OlegMishin/A1200_8MB_FASTRAM/Doc/IMG_5395.JPG

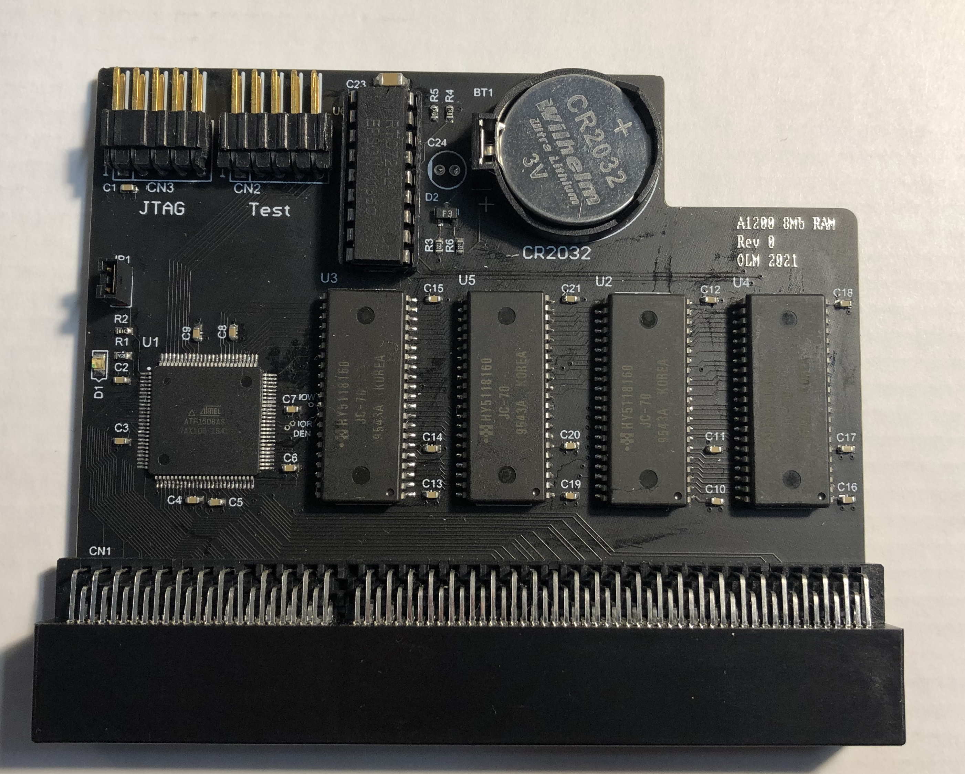
Doc/IMG_5395.JPG
