OlegMishin/A1200_8MB_FASTRAM/pcb/A1200_8MB_OLM-V2_BOM.pdf

No. | Quantity Designator | | Value | Part | Description
1 | 1 | BT1 | CR2032 holder | CR2032 holder | Battery holder
2 | 22 | C1, C2, C3, C4, C5, C6, C7, C8, C9, C10, C11, C12, C13, C14, C15, C16, C17, C18, C19, C20, C21, C22 | 100nF | 100nF 50V 0603 | Capacitor
3 | 1 | C23 | 10uF | 10uF 16V 1206 | Capacitor
4 | 1 | C24 | 100uF | 100uF 16V D5 | Polarized Capacitor
5 | 2 | C25, C26 | 22pF | 22pF 50V 0603 | Ceramic capacitor SMD
6 | 1 | CN1 | A1200_EXP_CONN | A1200_EXP_CONN | A1200_150pin_expansion_connector
7 | 1 | CN3 | PLD-10R | PLD-10R | Header, 5-Pin, Dual row, Right Angle
8 | 1 | D1 | APTD3216MGC | APTD3216MGC | LED SMD 1206
9 | 1 | D2 | BAT54C | BAT54C | Schottky Barrier Double Diode
10 | 1 | JP1 | PLS-2 | PLS-2 | Header, 2-Pin
11 | 3 | R1, R3, R6 | 470 | 470 5% 0603 | Resistor
12 | 3 | R2, R4, R5 | 10K | 10K 5% 0603 | Resistor
13 | 1 | U1 | ATF1508AS-7AX100 | ATF1508AS-7AX100 | MAX 7000S 5V CPLD
14 | 4 | U2, U3, U4, U5 | MSM5118160 | MSM5118160 | 1Mx16 DRAM
15 | 1 | U6 | RTC72421 | RTC72421 | RTC IC
16 | 1 | ZQ1 | 32.768kHz | 830002996B Wurth Elektronik | Quarze WE-XTAL 32.7680kHz 20ppm WATCH 3X8

Страница 1 из 1
