OlegMishin/A1200_8MB_FASTRAM/pcb/A1200_8MB_OLM-V2_Schematics.PDF

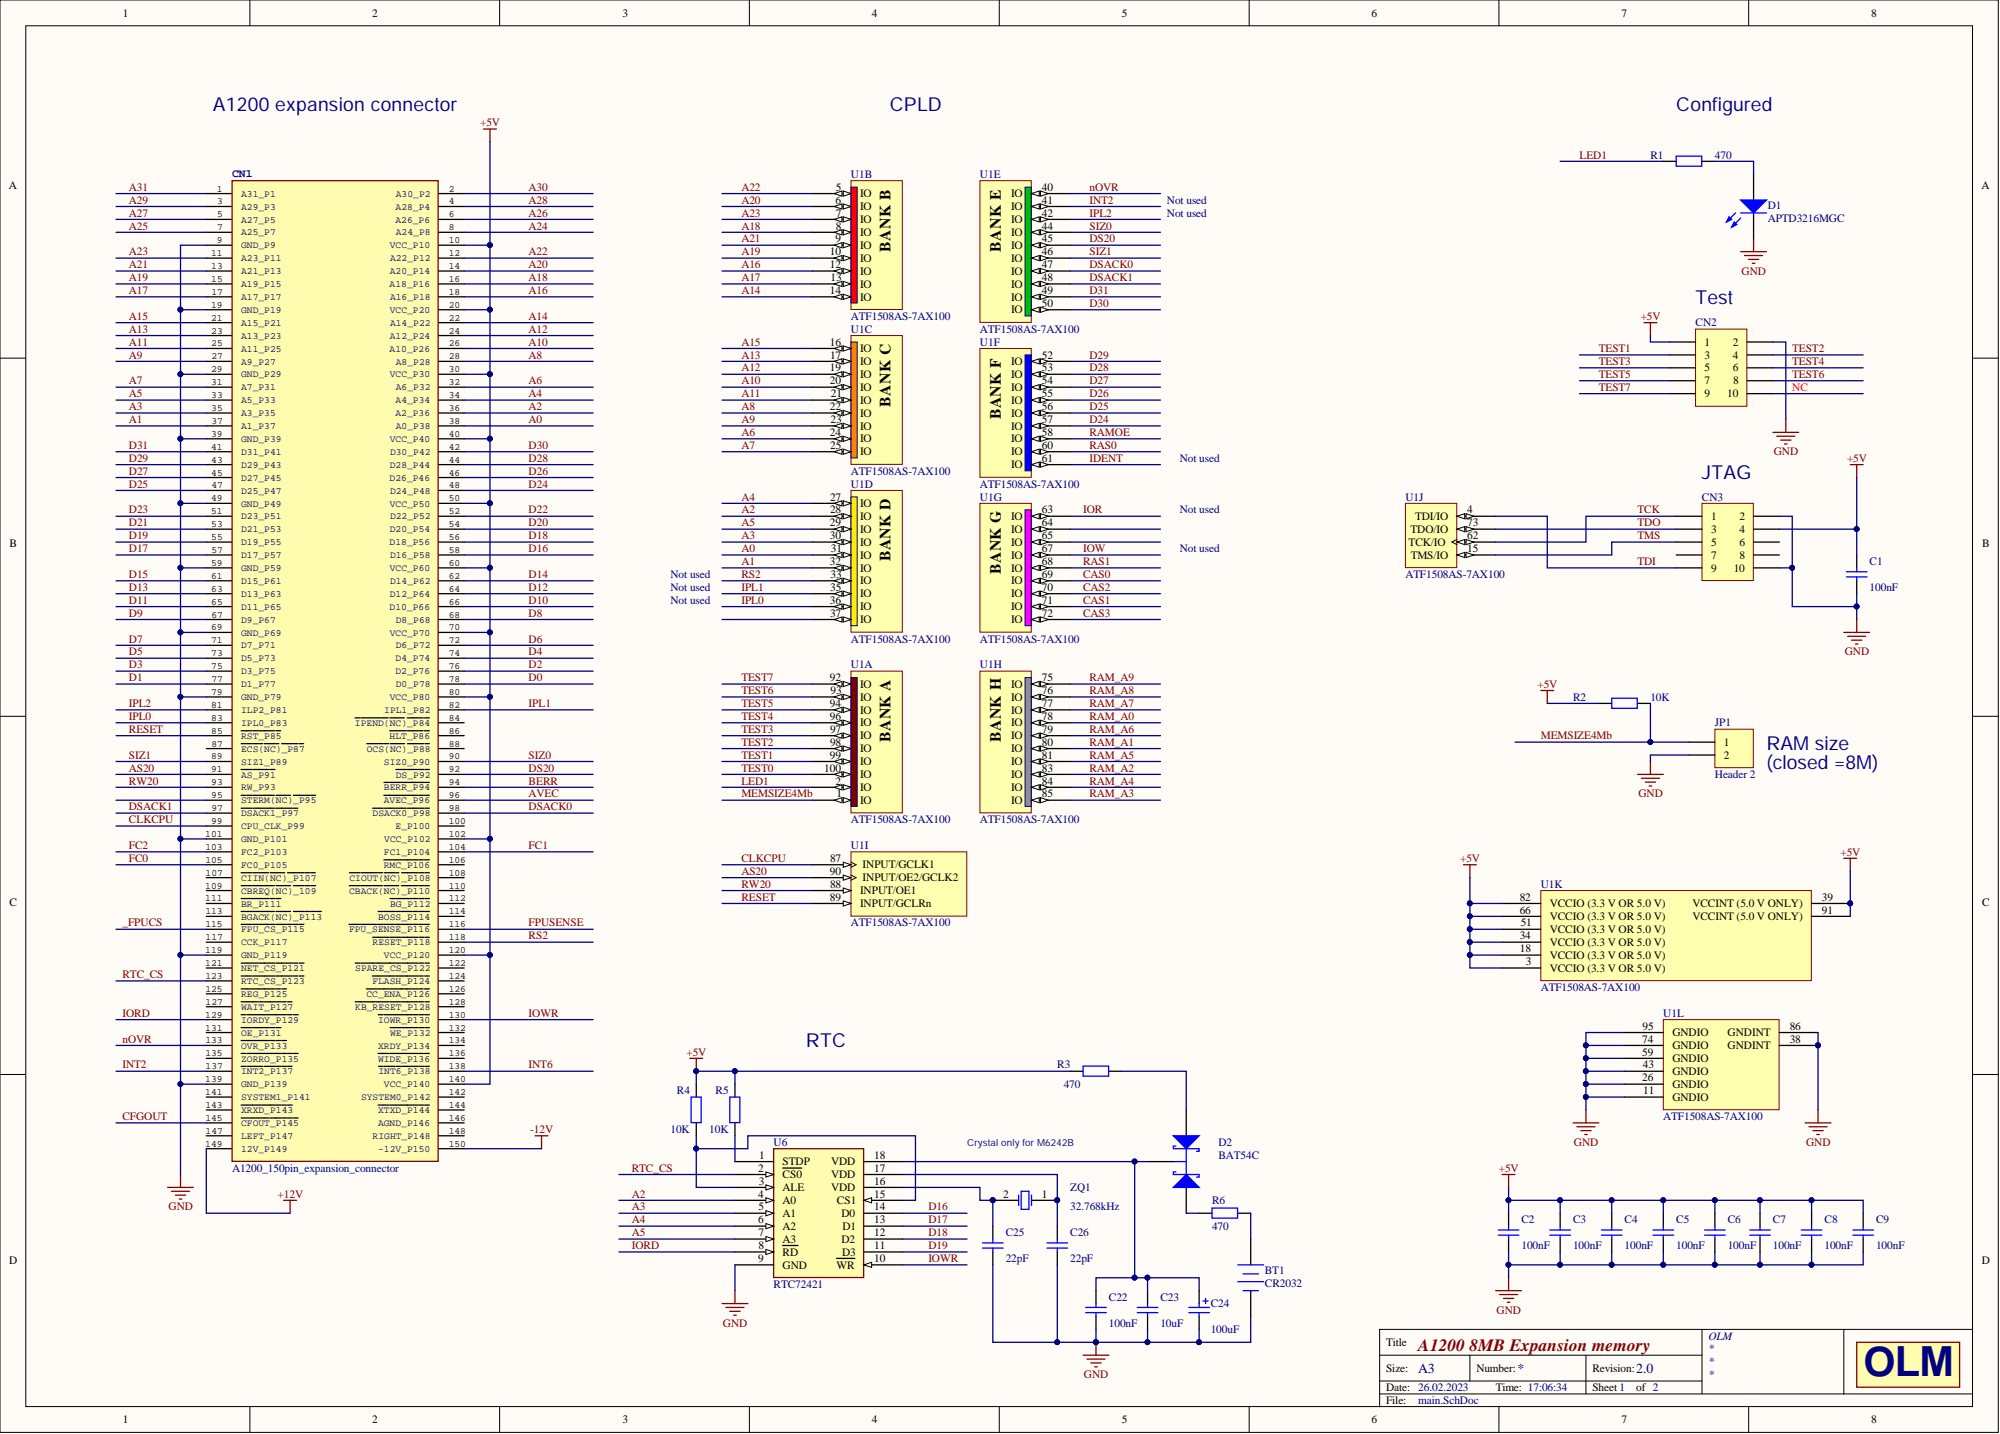
[picture p2: page 1]

7 3 | TCK TDO TMS TDI

6 2
1 5

1 6
1 5 | D16

T i tle | OLM ***

Siz e : A 3 | Numbe r : | Revis ion :
Dat e : T i m e : | | She e t 1 o f 2

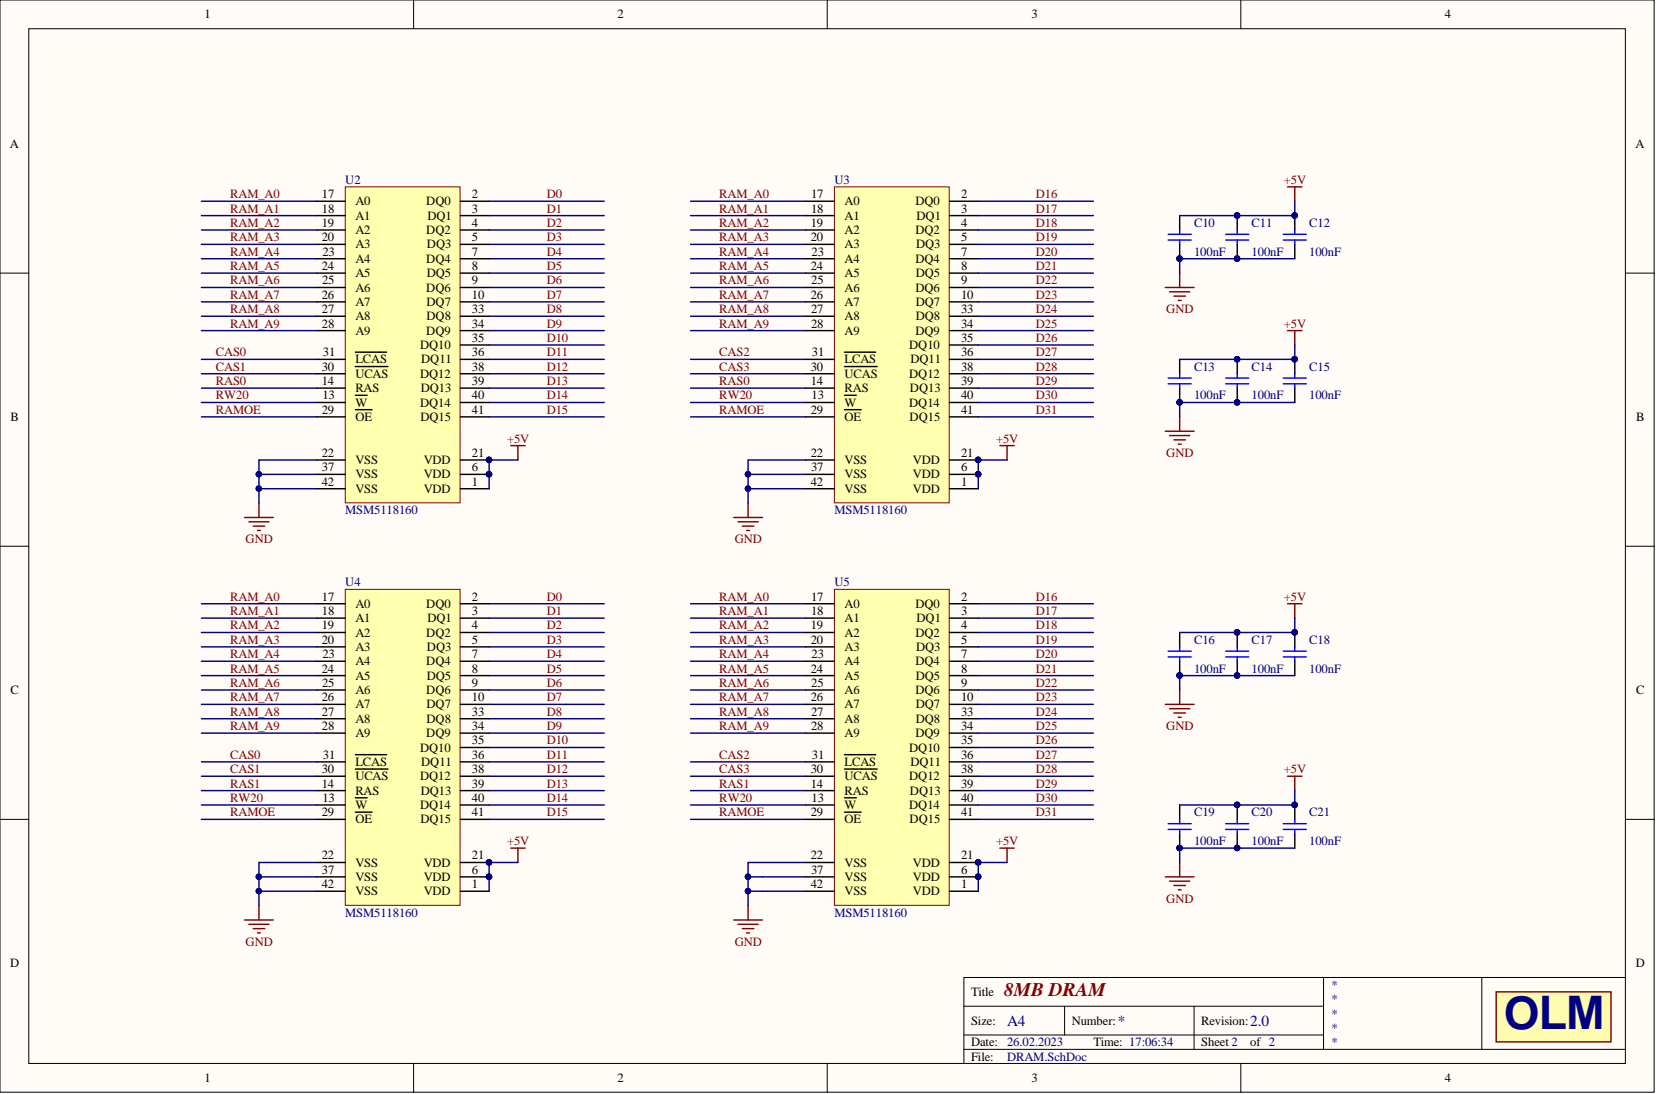
[picture p3: page 2]

8MB DRAM T i tle | **** *

Siz e : A 4 | Numbe r : * | Revis ion : 2.0

Dat e : 26.02.2 023 T i m e : 17: 06: 3 4 | | She e t 2 o f 2
