OlegMishin/A1200_8MB_FASTRAM/(threads)

Thread 1 (2022-01-31):

#amigarus

devstratum, 2022-01-31:
Привет Олег! Если есть телега, то народ хотел бы с тобой пообщаться в группе русских амижников #amigarus

OlegMishin, 2022-01-31:
Привет Сергей,
К сожалению, телеги у меня нет. Есть другие варианты(форум, whatsapp etc)?

Олег

devstratum, 2022-01-31:
Принято, если будет telegram, заходи в русскоязычную группу амижников.
Тебе от народа привет и уважуха за открытые проекты железа для платформ компьютеров Амиг!

OlegMishin, 2022-01-31:
Большое спасибо! Буду иметь в виду :)

Closed 2022-01-31.

Thread 2 (2022-09-14):

Amiga wont boot with card in it, need help

Retrofletch, 2022-09-14:
I am using EPM7128STC100-10 and im programming it with the pld_ram.pof file found in output files, it programs and verifies fine, but card will not boot or even output video with card in.

I have jumper on
no battery or RTC installed to simplify things.
I have tried to boot a card with no ram chips installed at all and still no boot or video output, the machine just dont want to start.
Im not sure that i programmed it with correct file but it atleast seems like it? and chips should be correct because pof file states "EPM7128STC100-10" in the header.

soldering is good, ive double tripple checked.

any ideas? should card boot with no ram chips or not?

rev1 pcb

OlegMishin, 2022-09-14:
Hi,
In general, I would start troubleshooting from the main connector. As I had many issues with it. It is very sensitive to tilting. E.g. if the expansion card is not parallel to the main board. Next, I would check clock and address signals are coming to the CPLD. Also the CPLD has a couple of test signals on "Test" connector as below, so you can check if address decoder works:
assign TEST[0] = Z2_ADDRESS; //p100 - Zorro2 address access
assign TEST[1] = Z2_nWRITE; // p99 - Zorro2 write
assign TEST[2] = Z2_nREAD;  // p98  - Zorro2 read
assign TEST[3] = configured;// p97  - Kickstart configured the RAM
assign TEST[4] = debug_bit;  - set if shutup command received
assign TEST[5] = FR_RESET; - delayed RESET
assign TEST[6] = POR[2]; - Reset counter (used for the above delay)
assign TEST[7] = (A[23:16] == 8'hE8); - access to address space 0xE80000

I did not try to start the card without RAM chips, so can not say how it behave.

Retrofletch, 2022-09-15:
Connector seems fine no pins seems off, i even touched up all sodlering points but no change.
i have another 8mb card ( the one based on tf328 ) uses same connector i plug that in and no issue with that.

14mhz clock does make it to the cpld, there are some activity on adress for a second or so then it all shuts down, some of the test points goes high ( it seems ) but not sure what to make of it..

i feel like something is up with the cpld, can you confirm that the file i programmed is correct and works for you?
i will build another one when i get more a1200 connectors next week and see if second card acts the same.. its verry odd =/
Was hoping i could get this one working as the xilinx parts for the edu arana one is getting hard to buy and the added RTC is nice bonus.

anyways thanks for responding.

Retrofletch, 2022-09-15:
I will build another one next week, if it acts same way I can just send you the card along with a couple epm's if you wish, unfortunatly troubleshooting this is a bit out of my league

OlegMishin, 2022-09-15:
Sounds good for me if it is ok for you to ship to Germany. It would be nice to check the design with EPM.
Just couple of thoughts.
First, I hope you got the EPM's from a trusted seller(like Digikey or similar). I have some bad experience buying CPLDs from China :)
And second, I tested my card with the latest ReAmiga only. If you have some other revision mainboard it might be needed to apply "Timing Fix" like discussed here:
https://retrocomputing.stackexchange.com/questions/609/what-are-the-amiga-1200-timing-fixes

bfgmatik, 2023-02-25:
Just wanted to advise that Retrofletch's problems may be caused by the same reason as mine (D16 and D17 short by 5V via). After fix my card works properly. Thanks for a good work!

OlegMishin, 2023-02-25:
@bfgmatik thank you for the finding. And my apologies for the stupid mistake. Normally I do DRC every time when change something. Seems in this case I forgot to do that. As this revision was never produced(I still use my pilot board), the problem was not discovered.
Anyway, thanks again. The gerber files have been updated.

Regards
Oleg

Retrofletch, 2023-02-25:
Hello
@bfgmatik and @OlegMishin
I acctually put this whole thing on ice as i ordered new ram chips, i suspected i had used the wrong kind ( FPM vs edo ) and never got around to testing any more.

I just checked D16 and D17 and sure enough, they are both shorted to 5v, as there are no kicad files available im struggling to find best place to resolve this issue, how did you bodge it on your card bfgmatik?

thank you for taking the time to troubleshoot this issue, it was beyond my own capability unfortunatly.

and Oleg, no need to apogogise these things happen and i took a calculated risk ordering untested board, im happy people bother putting their stuff on github in the first place!

Retrofletch, 2023-02-25:
Also a bit unrelated to the boot issue, but mentioned was that the rev0 did not fit well and had to be filed down, i have same issue still on the rev1 board, i had to file it down on the side next to the battery holder to make it fit, it seems there are no tracks there so i think the pcb could be adjusted quite easily to make it a better fit. did you experience this also @bfgmatik ?

bfgmatik, 2023-02-25:
The solution was to cut these two traces which are shorted a little further by 5V via. Of course it will make RTC not working and need to be rewired to proper RTC pins (after another cut after the via to remove short circuit on RTC side). I'm going to do it on Monday in my workshop. But for now it works correctly without RTC.
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
My board fits quite well into A1200, it could be around 0.5mm shorter on one side for better fitting. Also my RTC battery connector collides a little with bottom cap and should be moved at at least few milimeters in RTC direction. I had to use knife on bottom cap to make it compatible :).

bfgmatik, 2023-02-25:
I wonder how many people "borrowed" Oleg's design and started to sell it with this bug :). I bought my on Polish auction webpage. :D.

Retrofletch, 2023-02-25:
i will try this fix, thank you

well i know of atleast one guy on polish allegro who is well known for doing just that, and even sell things that say on pcb not to sell he just puts a sticker over it :) could not find this board in his items tho so maybe they have multiplied :p

bfgmatik, 2023-02-25:
He doesn't sell it because I bought his last one :). Well, a good thing about that was that this PCB was quite heap compared to ordering 1 piece of 4-layer PCB even from China.
Some more pictures about my board dimension problems.
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

Retrofletch, 2023-02-25:
Yes that on the second image is exactly where my board is hitting aswell, i think remove even 1-2mm there would help, my board sits at a slight angle on the edge connector as it is wich worry me a bit. there is no traces there so should be no issue.

and also, good news, i cut the two traces on my board, now it boots fine and 8mb shows up in ATK, seems this was only issue! amazing!

OlegMishin, 2023-02-25:
Thanks for your feedback, guys. I can update the board outline as well.
Did I get correctly, it should be modified like below, right?
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

Retrofletch, 2023-02-25:
That would be perfect yes!

bfgmatik, 2023-02-25:
In my opinion also CR2032 should be moved at least 5mm left (towards RTC) to fit with my battery holder and bottom cap/cover. Maybe my holder is taller or wider than your but all of them are quite similar.

bfgmatik, 2023-02-25:
OK, this may be only the matter of my battery holder, because it goes out of the silkscreen line so I assume that yours have a little different dimensions.

Retrofletch, 2023-02-26:
i cut the traces both sides of the via and linked up again with some enamel wire and poured some solder mask over it to secure it all, RTC works as it should aswell now.
so with these small fixes to the board i think we got a winner :)

OlegMishin, 2023-02-26:
@Retrofletch good to read that. Checking again the board with my Amiga, I found that the battery holder indeed is to close to board edge and I did cut some plastic of Amiga's case. Already forgot about that :)
I've fixed the board and uploaded schematic/gerbers as Rev 2.

Closed 2023-02-26.

Thread 3 (2023-02-25):

D16, D17 and 5V short-cicuit by 5V via?

bfgmatik, 2023-02-25:
Well, looks like there is a mistake on the PCB near R3 which causes a short circuit between D16, D17 and 5V. Can you confirm this? :)

OlegMishin, 2023-02-25:
You are right. Shame on me....
The board needs some surgery here(top view):
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

OlegMishin, 2023-02-25:
Gerbers have been updated.

Closed 2023-02-25.

Thread 4 (2023-03-13):

Production files and JLC

Retrofletch, 2023-03-13:
It seems with new December 2022 rules JLC will no longer accept the gerbers, I tried order the new revision

Their response is as follows: " As shown below, we have new rule since Dec, 2022, if the copper areas are less than 30% of the board in each copper layer, the space between trace and trace should be at least 0.15mm to avoid short circuit. The space in your file is not enough.

There are two option to deal with this case

A customer enlarge the space between trace and trace at least 0.15mm

B customer add more copper area to reach at least 30% of the inner layer. For the extra copper, if the copper surface are not a part of circuit net, we call false copper, please make sure the space between copper to the trace, pad, hole and real copper surface at least 1.0mm.
"

So I'm guessing adding some copper fill would resolve thus quite easy without having to mess with traces spacing.

They also said there is no defined keepout area but that is less of an issue as they can just use the outer frame of a layer.

I'd do it myself but only gerbers are available :)

OlegMishin, 2023-03-13:
Hi @Retrofletch,
Thanks for your feedback! I have updated the gerbers with the following:
1. increased clearance to 0.15 mm.
2. filled TOP/BOT layers with GND poly
Now it should fit JLC rules.

I would prefer not share the sources in public. Anyway, the project is in Altium Designer, might be not so much useful. If you need I can share the sources via email.

Retrofletch, 2023-03-13:
That seems to have fixed the issues, they accepted the gerbers now thanks

i know other people have had designs that passed on JLC previously without problem are now getting rejected and needed changes, mostly because the lack of copperfills.

No i understand not everyone want 20 slightly different versions of their designs out there that people are asking for support on, and i also do not know how to use altium so that probably would not have helped anyways :)

Think the board is all good now anyways, thanks for quick reply :)

OlegMishin, 2023-03-13:
No problem. Enjoy the building :)

Closed 2023-03-13.

Thread 5 (2024-12-27):

BOM

CCKMik, 2024-12-27:
HI
where can i find BOM file?

sausagejohnson, 2024-12-27:
I did find a BOM of sorts here: http://lvd.nedopc.com/Projects/a600_8mb/index.html at the a600_8mb_addon.zip. There is a BUILD.txt inside.

However it would be good to confirm if these are still the same parts for the A1200 version.

OlegMishin, 2024-12-28:
Hi,
I made a quick and dirty BOM for the project: https://github.com/OlegMishin/A1200_8MB_FASTRAM/blob/main/pcb/A1200_8MB_OLM-V2_BOM.pdf

CPLD can be 10 or -15ns grade. Not sure about 25ns.
There is a wide selection of DRAM which can be used in the project. I added a list to the end of the main description page.

Br
Oleg

CCKMik, 2024-12-28:
> Hi, I made a quick and dirty BOM

Thank you.

i found typo/typing error, ram:

it shoud be AS4C1M16E5 Alliance

sausagejohnson, 2024-12-29:
Thank you @OlegMishin this helps kickstart by getting the known parts. Very much appreciated.

OlegMishin, 2024-12-29:
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

Copy paste error fixed. Thanks!

CCKMik, 2025-02-17:
can i use CPLD:
altera EPM7128STC100
?

OlegMishin, 2025-02-17:
Sure.

Thread 6 (2025-10-03):

REFRESH

JV-Soft, 2025-10-03:
Здравствуйте , у вас хаотичная регенерация , AS (Address Strobe) на 68020 ведёт себя иначе: он может оставаться в «0» на протяжении нескольких тактов подряд (иногда очень долго), пока идут «back-to-back» циклы. То есть нельзя использовать только фронт/спад AS для генерации цикла памяти.
