OlegMishin/A1200_8MB_FASTRAM/(commit log)

2021-11-23 Initial commint
    [pld_ram.smp_dump.txt]
2021-11-23 firmware reuploaded
    [pld_ram.smp_dump.txt]
2023-02-25 Update a1200ram8mb_olm_Gerbers.zip
    Fixed short circuit issue between data bus D16, D17 lines and 5V by a VIA.
2023-02-26 Schematics and gerbers updated to rev 2
    Fixed short circuit issue and PCB size
